SohamKale83/Remote-Controller/(commit log)

2026-07-17 Added schematics of transmitter and receiver and updated the readme file
2026-07-31 Add future improvement section to README
    Added a section for future improvements including the addition of an OLED screen for battery health monitoring.
