SohamKale83/Remote-Controller/(notices)

Notices in the files:
README.md:
License: MIT
